dumpinfo/MICROMAKE_3D/MICROMAKE 原图/IMG_20150511_181304.jpg

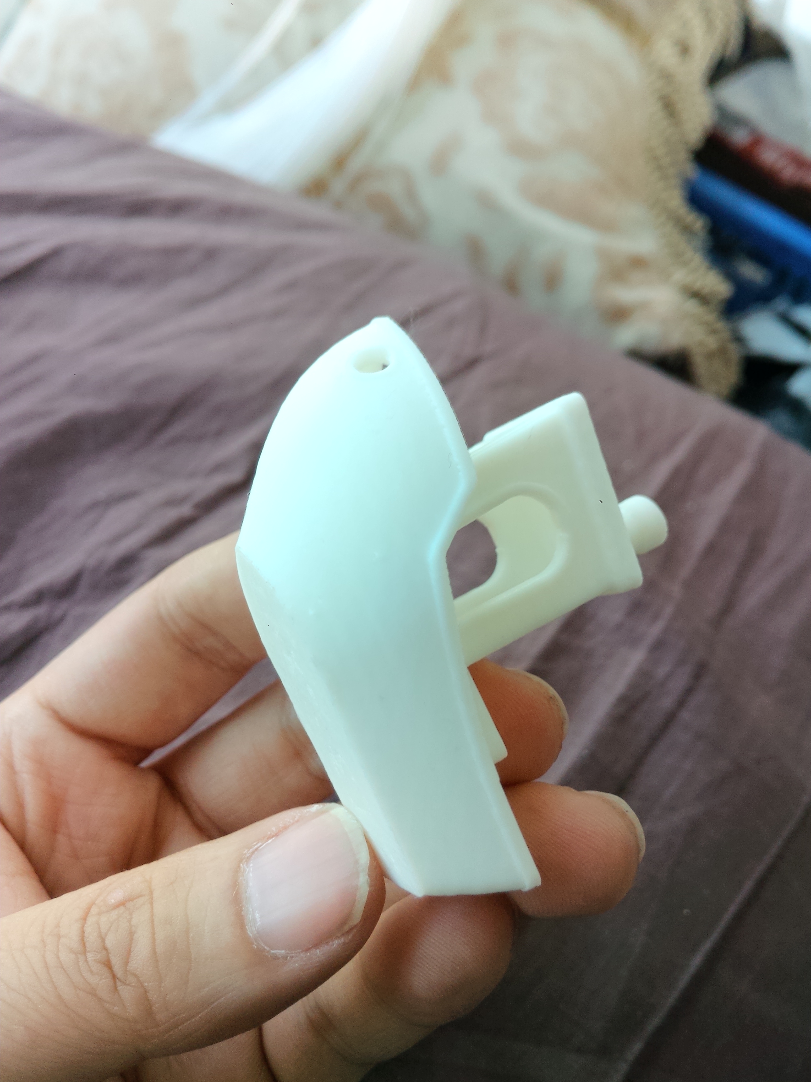
MICROMAKE 原图/IMG_20150511_181304.jpg
