dumpinfo/MICROMAKE_3D/MICROMAKE 原图/IMG_20150913_160210.jpg

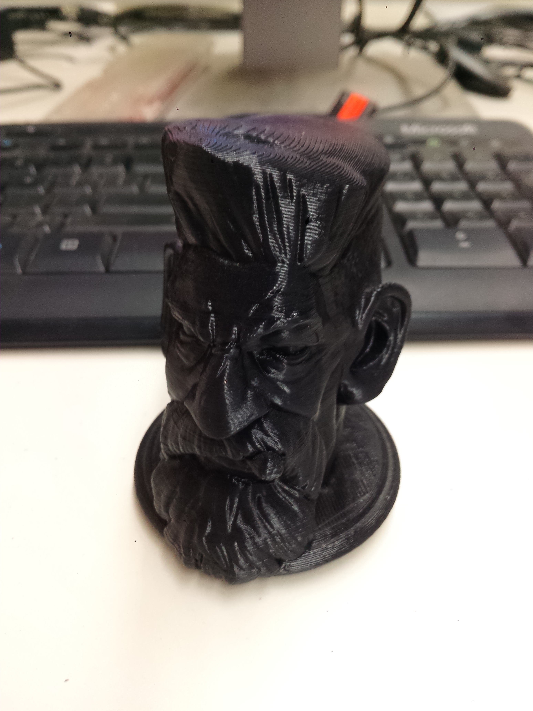
MICROMAKE 原图/IMG_20150913_160210.jpg
