dumpinfo/MICROMAKE_3D/MICROMAKE 文档/Micromake 3D打印机Mac系统软件安装.pdf

1、网盘【MICROMAKE】目录下载，Cura-15.04.0822-MacOS.dmg，双击载入镜像安装。 2、网盘【MICROMAKE 文档】目录下载 CH341SER_MAC.ZIP，解压后运行 CH34x_Install.pkg 安装串口驱动后重启。
3、打开 Cura，选择 Micromake D1 机型后，【机型】菜单，点击【安装默认固件】。（Mac 系 统串口波特率最高 115200，必须重刷固件换成 115200 波特率版本）。 4、如无法连接打印机，请打开 Cura【机型】【机型设置】，确认波特率是设置成 115200 的， 并且点击端口后面的下拉列表，看是否识别出串口，如/dev/cu.wchusbserial1410 类似，如 没有的话，请升级 OS X 10.9 以上版本系统。 5、打印机液晶屏菜单，【Configuration】【General】查看 Baudrate 是否为 115200，如不 是，请进行第 3 步的重刷固件。
