dumpinfo/MICROMAKE_3D/MICROMAKE 文档/金属液晶屏外壳安装教程.pdf

# 金属液晶屏外壳安装教程

## 所需工具：

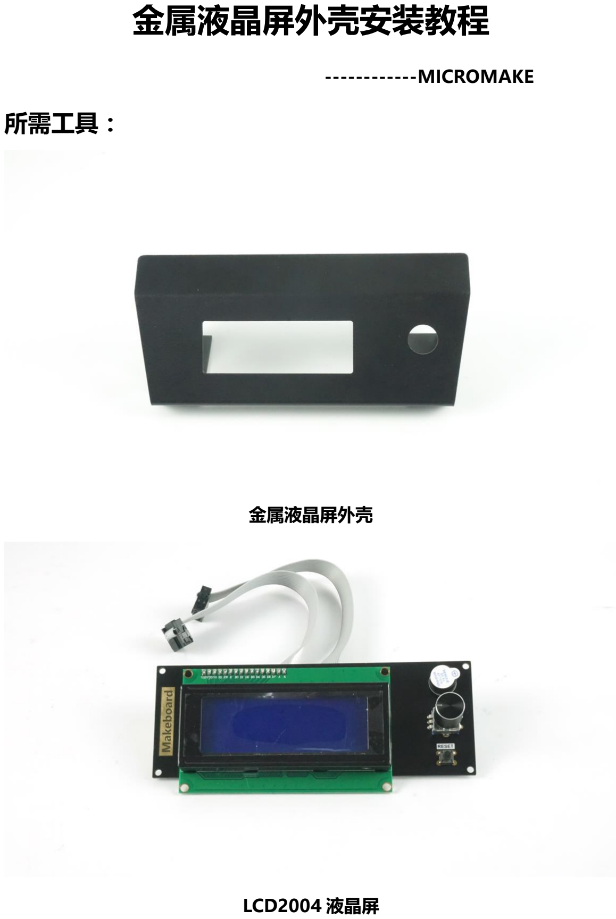
[picture p17: page 1]

------------MICROMAKE

金属液晶屏外壳

LCD2004 液晶屏

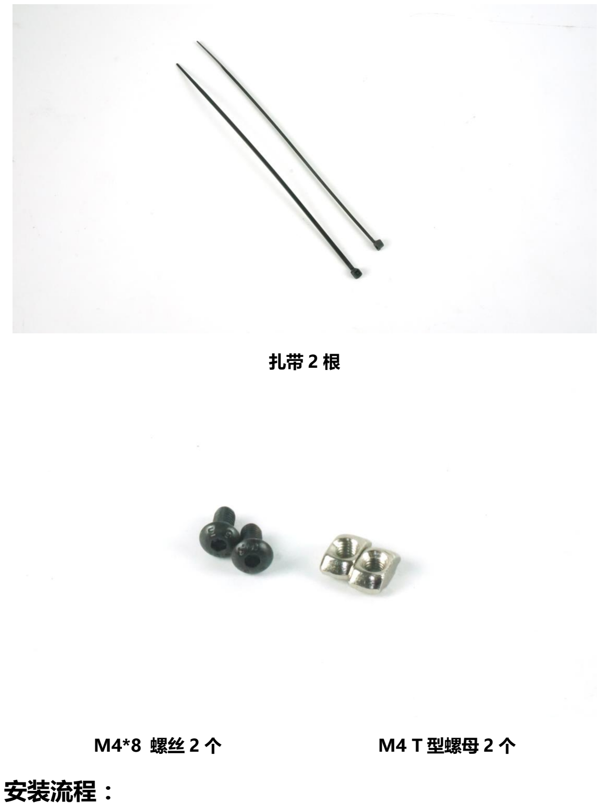
[picture p18: page 2]

扎带 2 根

M4*8 螺丝 2 个 | M4 T 型螺母 2 个

## 安装流程：

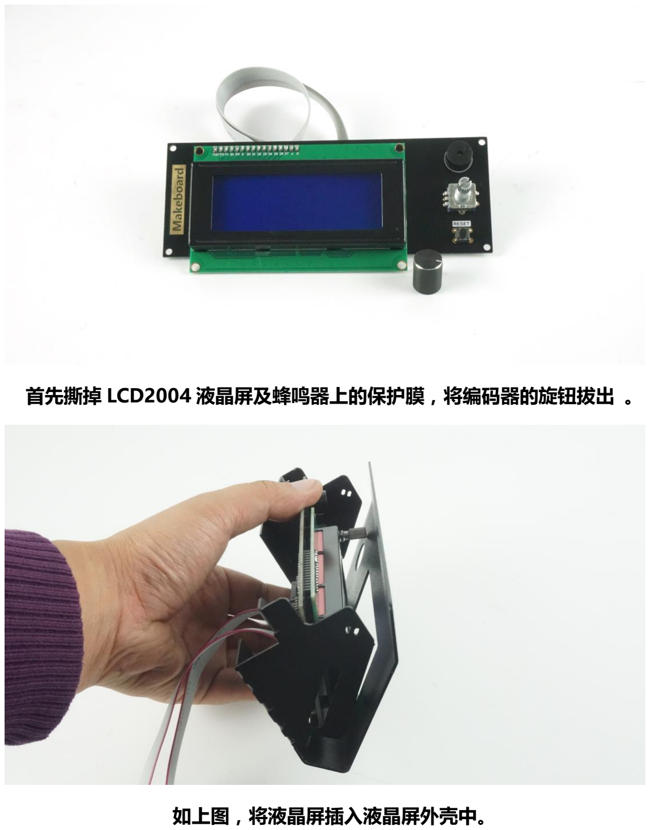
[picture p19: page 3]

首先撕掉 LCD2004 液晶屏及蜂鸣器上的保护膜，将编码器的旋钮拔出 。

如上图，将液晶屏插入液晶屏外壳中。

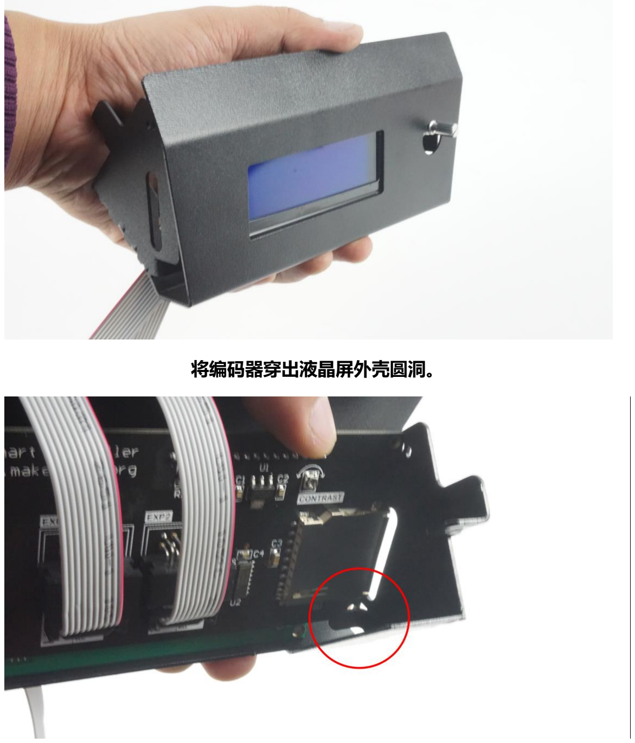
[picture p20: page 4]

将编码器穿出液晶屏外壳圆洞。

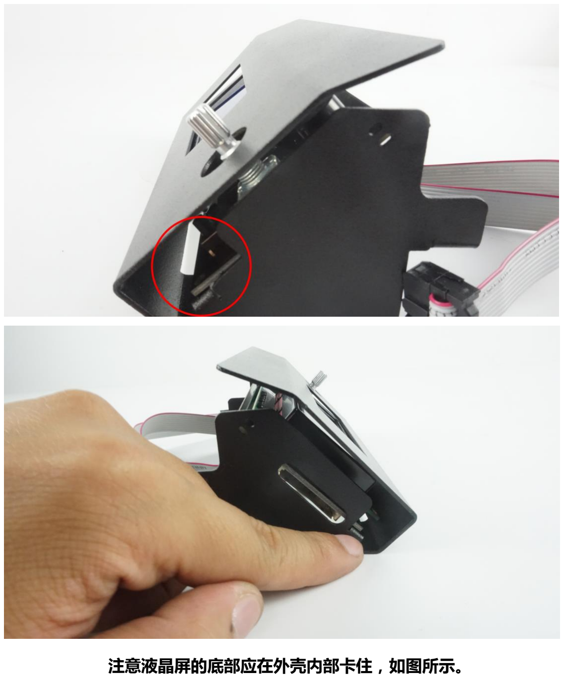
[picture p21: page 5]

注意液晶屏的底部应在外壳内部卡住，如图所示。

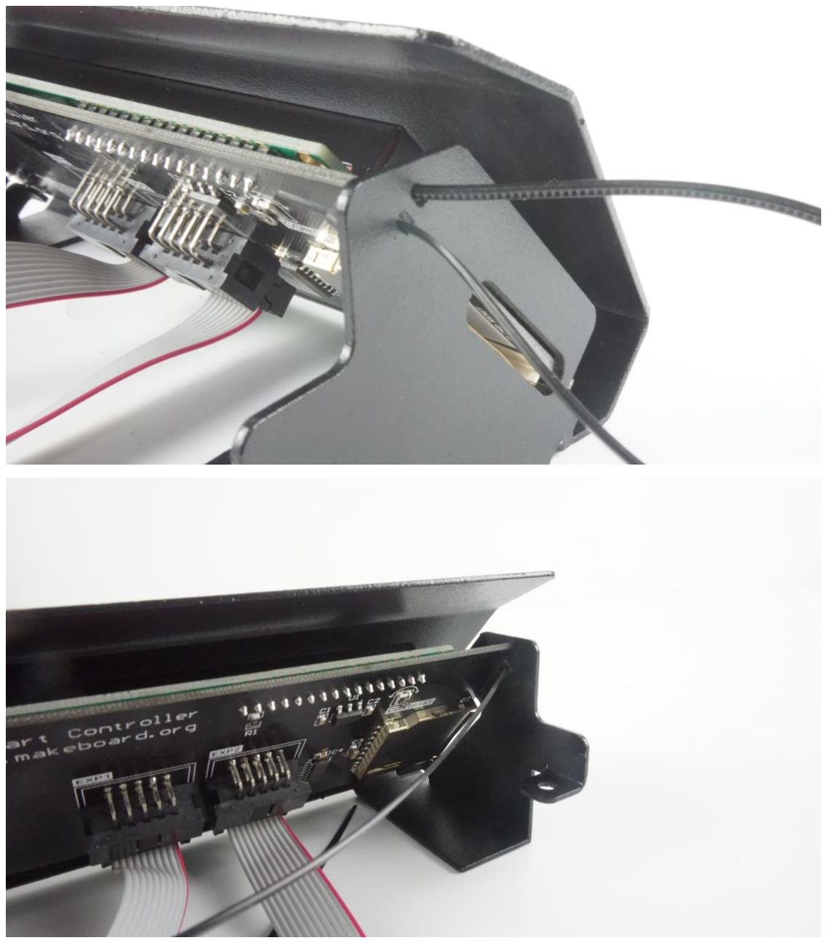
[picture p22: page 6]
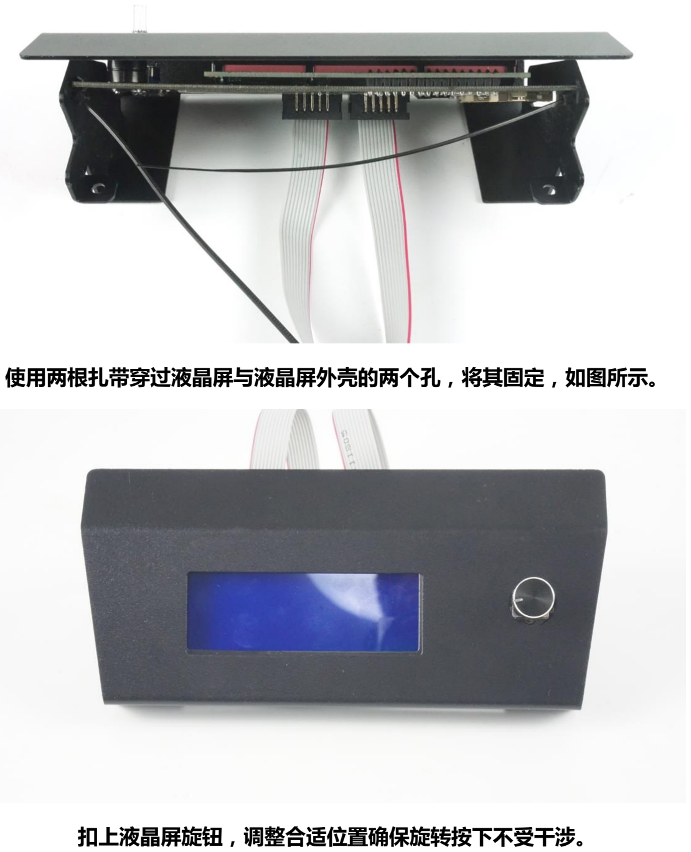
[picture p23: page 7]

使用两根扎带穿过液晶屏与液晶屏外壳的两个孔，将其固定，如图所示。

扣上液晶屏旋钮，调整合适位置确保旋转按下不受干涉。

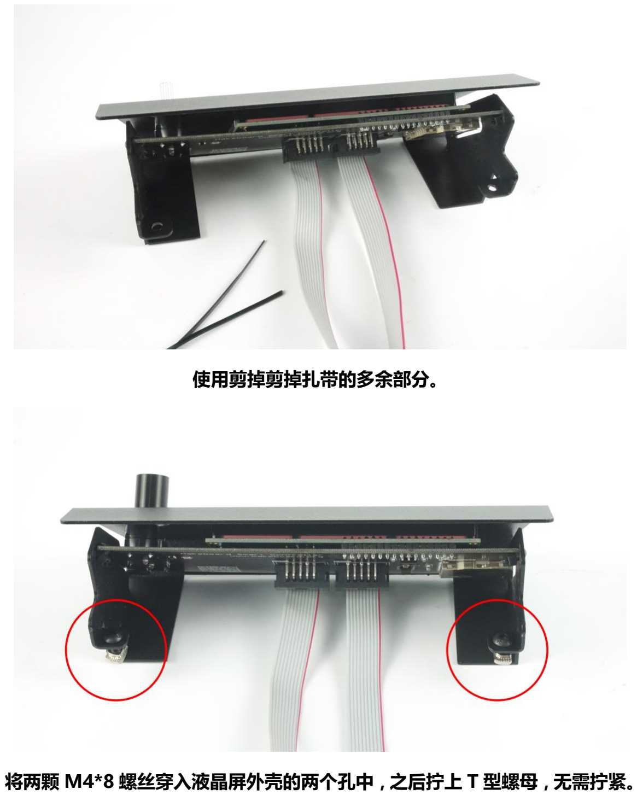
[picture p24: page 8]

使用剪掉剪掉扎带的多余部分。

将两颗 M4*8 螺丝穿入液晶屏外壳的两个孔中，之后拧上 T 型螺母，无需拧紧。

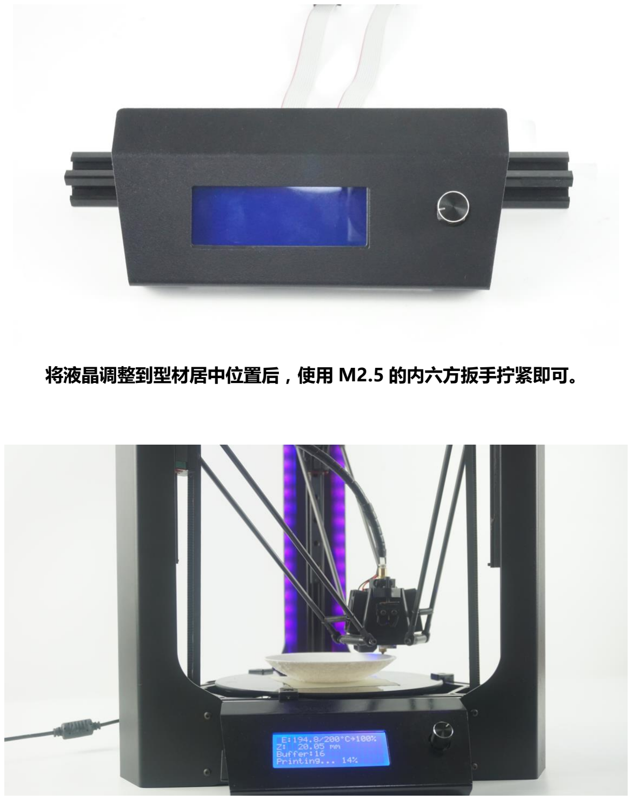
[picture p25: page 9]

将液晶调整到型材居中位置后，使用 M2.5 的内六方扳手拧紧即可。
