dumpinfo/MICROMAKE_3D/MICROMAKE 原图/IMG20151123162052.jpg

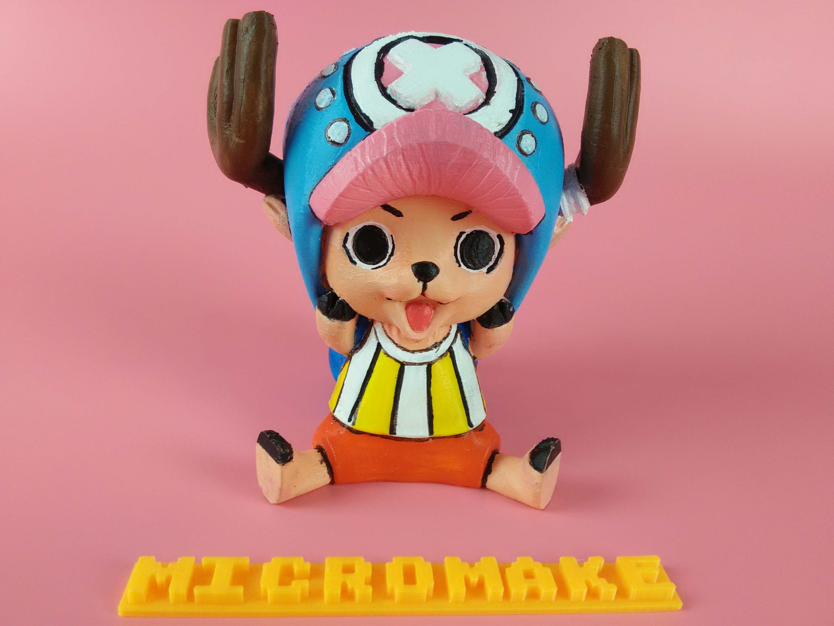
MICROMAKE 原图/IMG20151123162052.jpg
