dumpinfo/MICROMAKE_3D/MICROMAKE 原图/IMG_20150512_173231.jpg

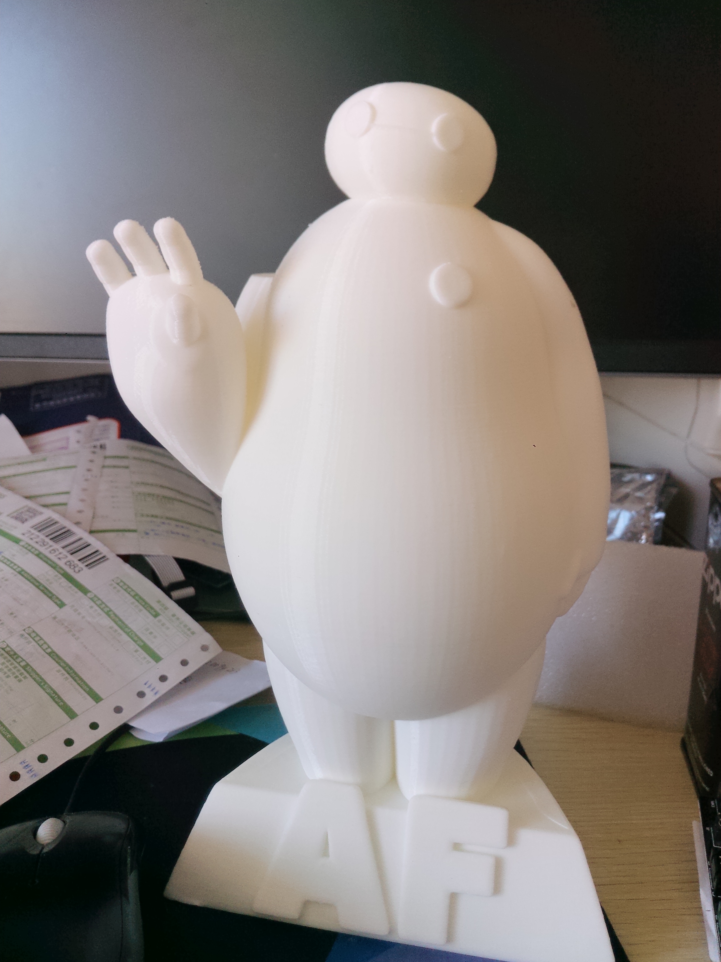
MICROMAKE 原图/IMG_20150512_173231.jpg
