dumpinfo/MICROMAKE_3D/MICROMAKE 原图/IMG_20150521_191225.jpg

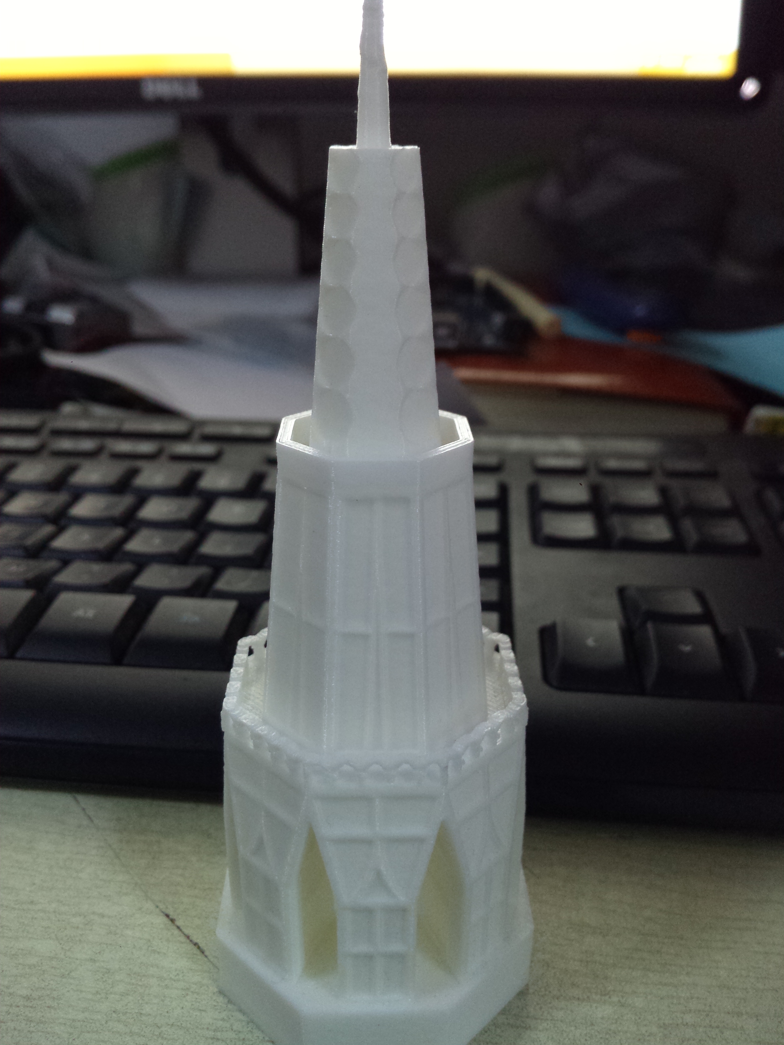
MICROMAKE 原图/IMG_20150521_191225.jpg
