dumpinfo/MICROMAKE_3D/MICROMAKE 原图/IMG_20150529_174008.jpg

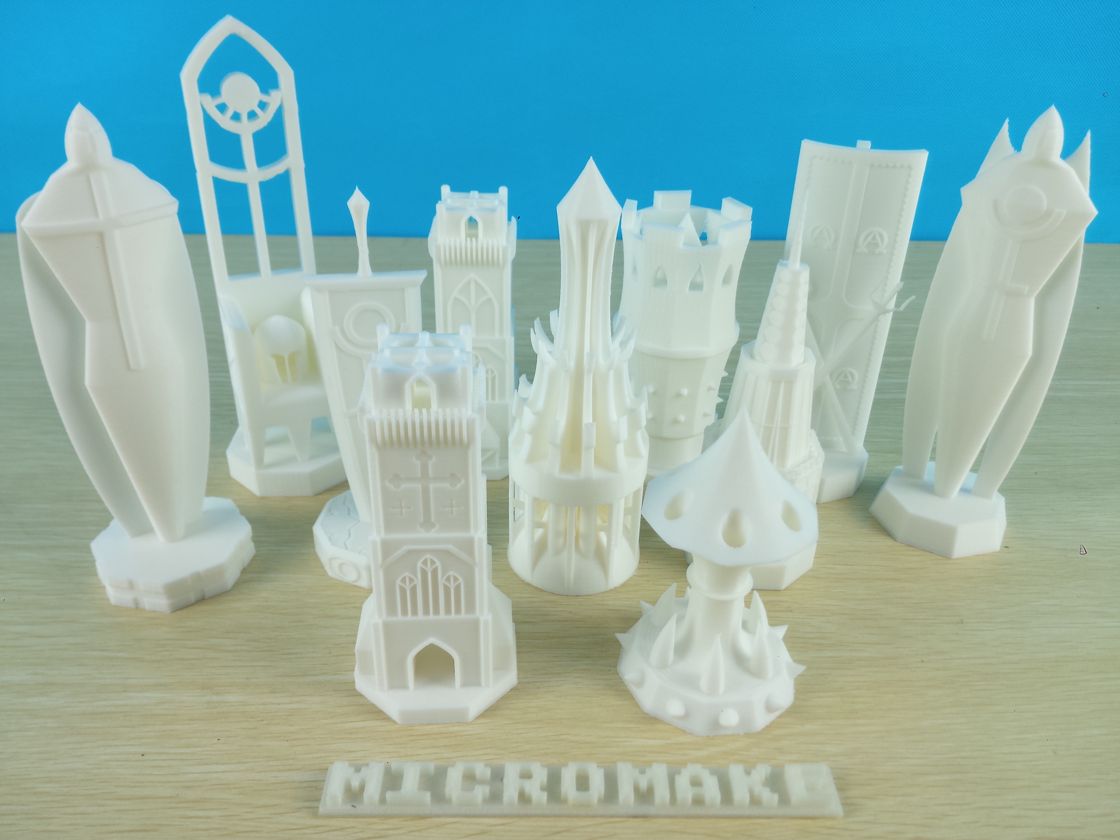
MICROMAKE 原图/IMG_20150529_174008.jpg
