dumpinfo/MICROMAKE_3D/MICROMAKE 原图/IMG_20150719_093453.jpg

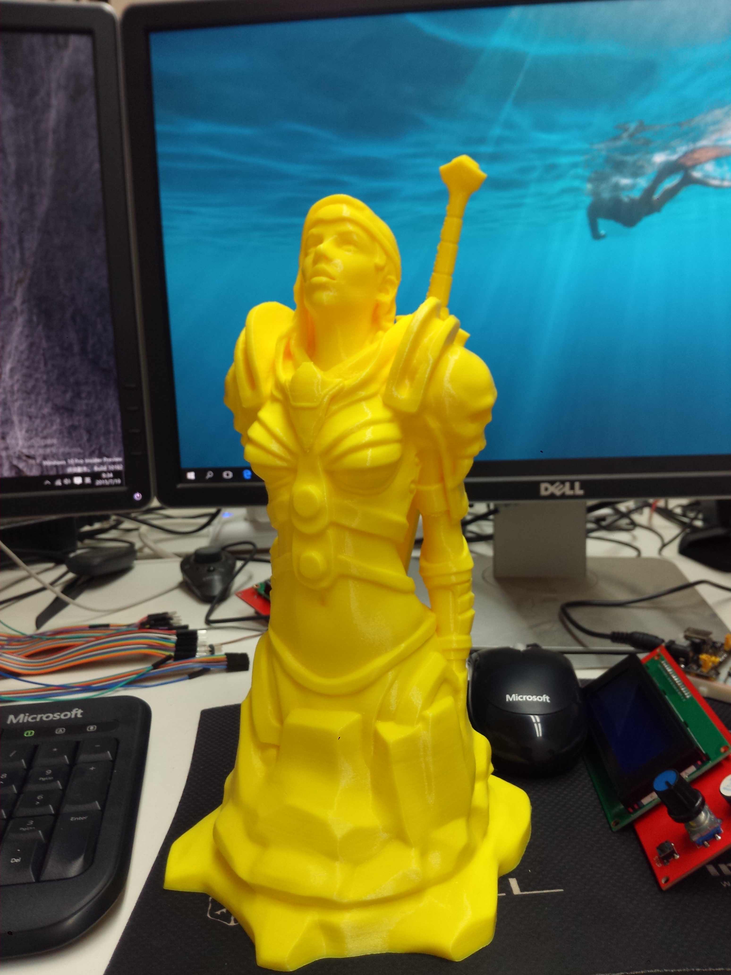
MICROMAKE 原图/IMG_20150719_093453.jpg
