dumpinfo/MICROMAKE_3D/MICROMAKE 原图/IMG_20151117_130504.jpg

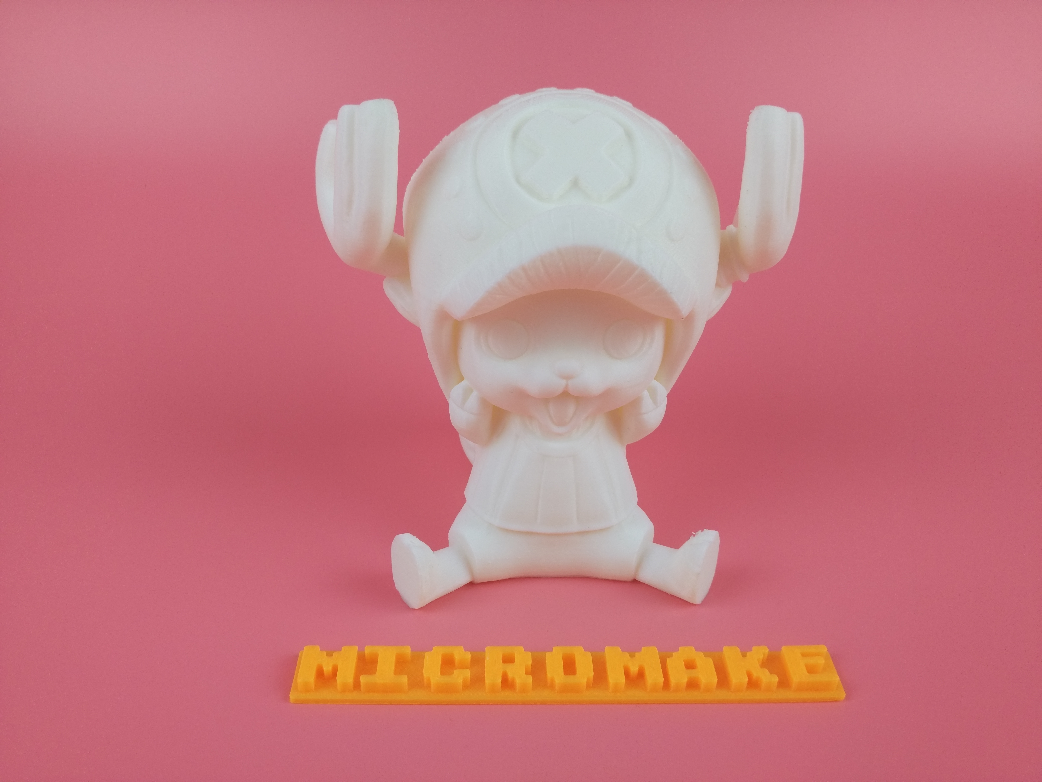
MICROMAKE 原图/IMG_20151117_130504.jpg
