dumpinfo/MICROMAKE_3D/MICROMAKE 原图/IMG_20151117_131758.jpg

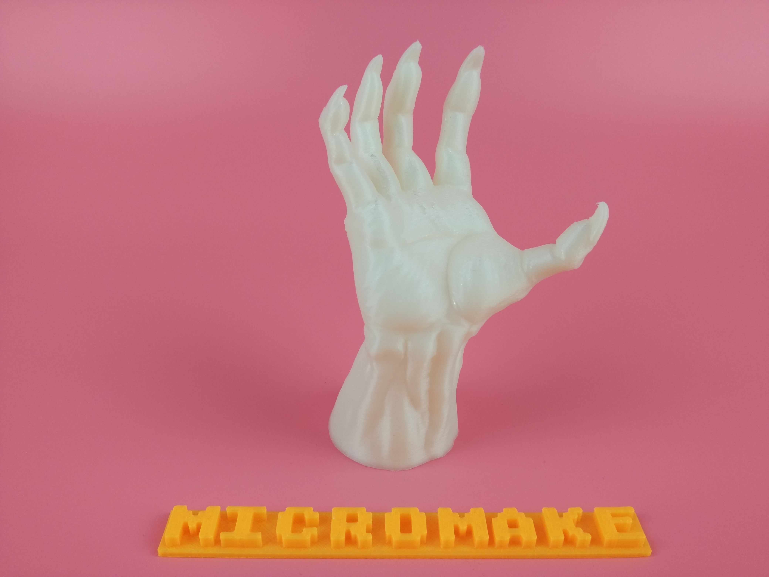
MICROMAKE 原图/IMG_20151117_131758.jpg
