dumpinfo/MICROMAKE_3D/MICROMAKE L1 光固化资料/测试模型/僵尸猎人头.stl

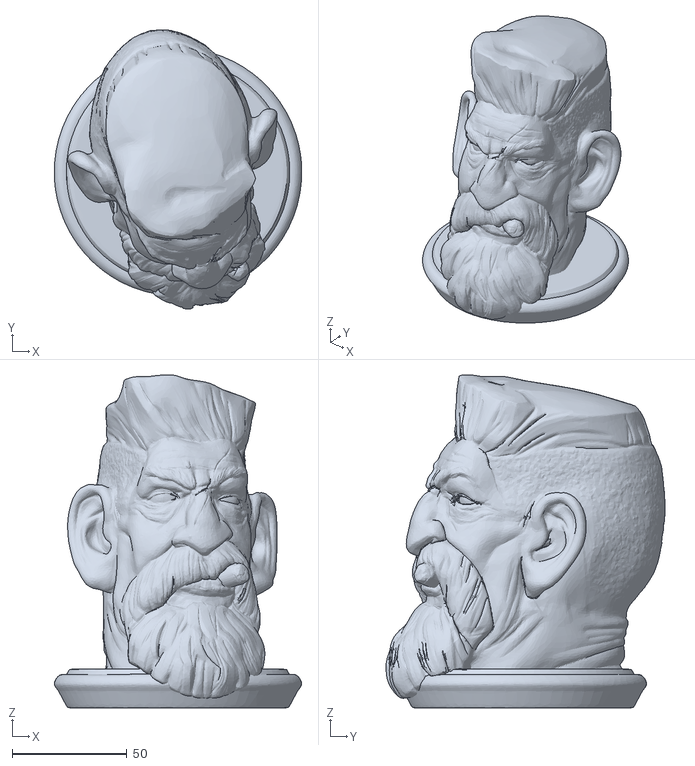
[picture p35: CAD file, 2019-02-17]
MICROMAKE L1 光固化资料/测试模型/僵尸猎人头.stl
107.7 x 121.6 x 145.0
