dumpinfo/MICROMAKE_3D/MICROMAKE 模型/全套非标件模型/螺丝.STL

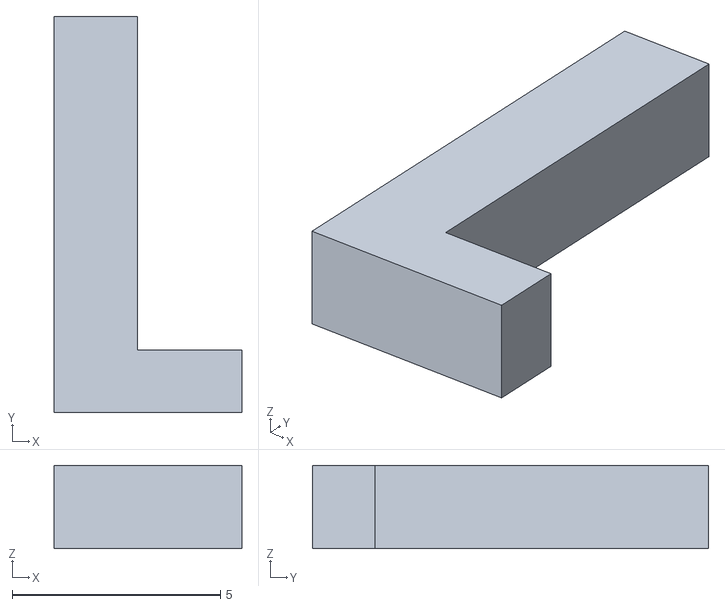
[picture p36: CAD file, 2019-02-17]
MICROMAKE 模型/全套非标件模型/螺丝.STL
4.50 x 9.50 x 2.00
