dumpinfo/MICROMAKE_3D/MICROMAKE 模型/手动调平用模型/手动测试.amf

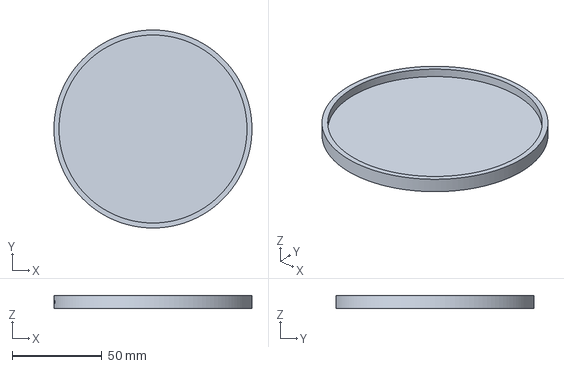
[picture p37: CAD file, 2019-02-17]
MICROMAKE 模型/手动调平用模型/手动测试.amf
110.0 x 110.0 x 6.96 mm
