dumpinfo/MICROMAKE_3D/MICROMAKE 模型/料架.STL

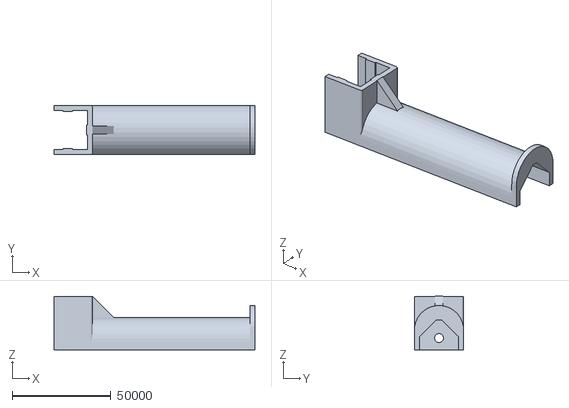
[picture p38: CAD file, 2019-02-17]
MICROMAKE 模型/料架.STL
102000.0 x 25000.0 x 27250.0
