dumpinfo/MICROMAKE_3D/MICROMAKE L1 光固化资料/测试模型/标准模型.stl

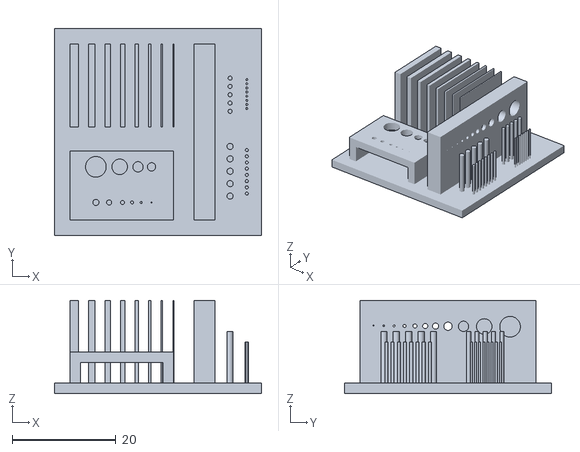
[picture p39: CAD file, 2019-02-17]
MICROMAKE L1 光固化资料/测试模型/标准模型.stl
40.0 x 40.0 x 18.0
