dumpinfo/MICROMAKE_3D/MICROMAKE 模型/全套非标件模型/T型螺母.STL

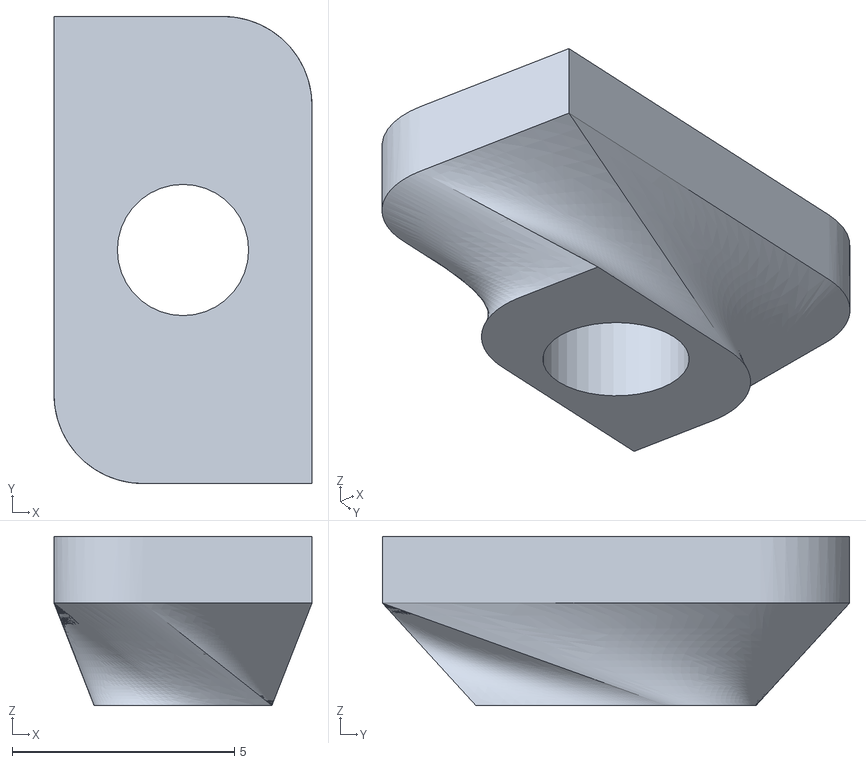
[picture p40: CAD file, 2019-02-17]
MICROMAKE 模型/全套非标件模型/T型螺母.STL
5.80 x 10.5 x 3.80
