dumpinfo/MICROMAKE_3D/MICROMAKE L1 光固化资料/测试模型/test.stl

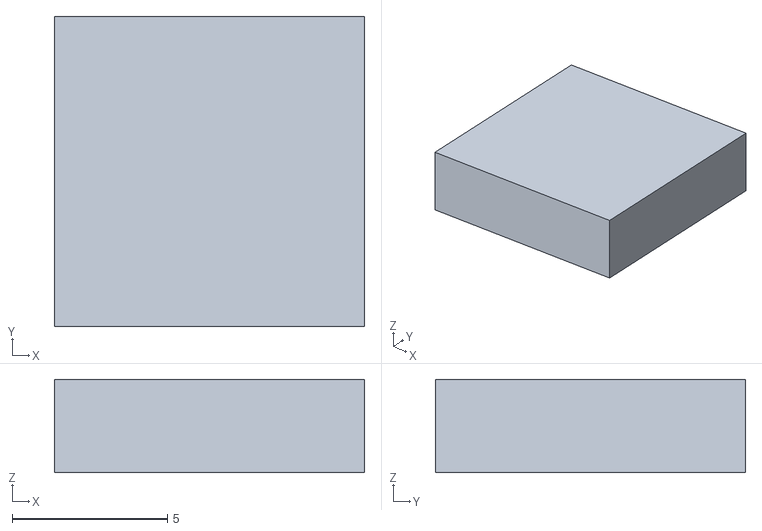
[picture p41: CAD file, 2019-02-17]
MICROMAKE L1 光固化资料/测试模型/test.stl
10.0 x 10.0 x 3.00
