dumpinfo/MICROMAKE_3D/MICROMAKE 模型/全套非标件模型/效应器.STL

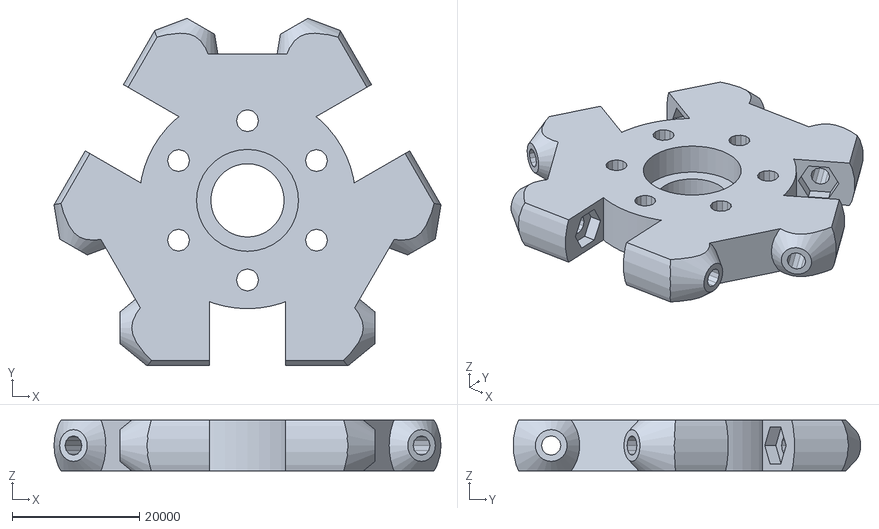
[picture p42: CAD file, 2019-02-17]
MICROMAKE 模型/全套非标件模型/效应器.STL
60744.2 x 54515.7 x 8000.0
