dumpinfo/MICROMAKE_3D/MICROMAKE L1 光固化资料/测试模型/插扣单支撑.stl

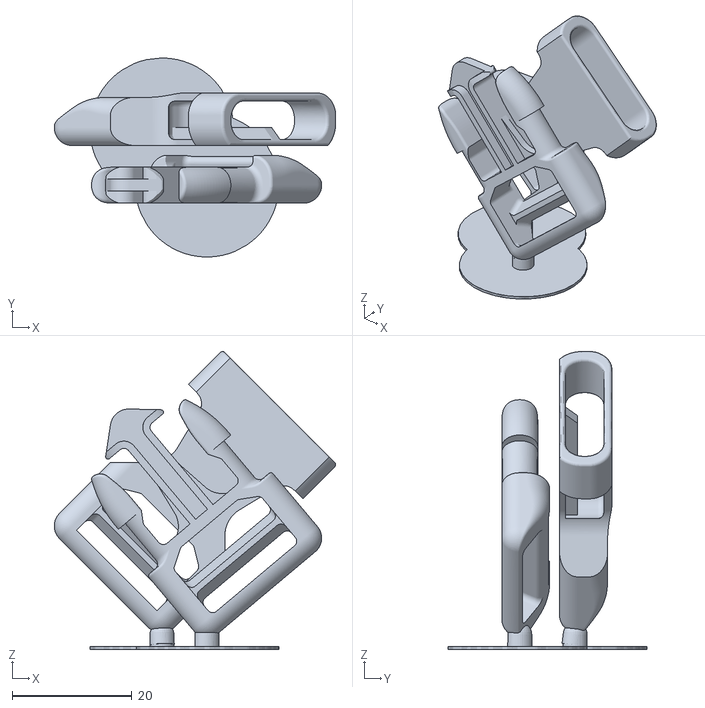
[picture p43: CAD file, 2019-02-17]
MICROMAKE L1 光固化资料/测试模型/插扣单支撑.stl
47.0 x 33.2 x 49.7
