dumpinfo/MICROMAKE_3D/MICROMAKE 模型/全套非标件模型/线轨皮带连接件.STL

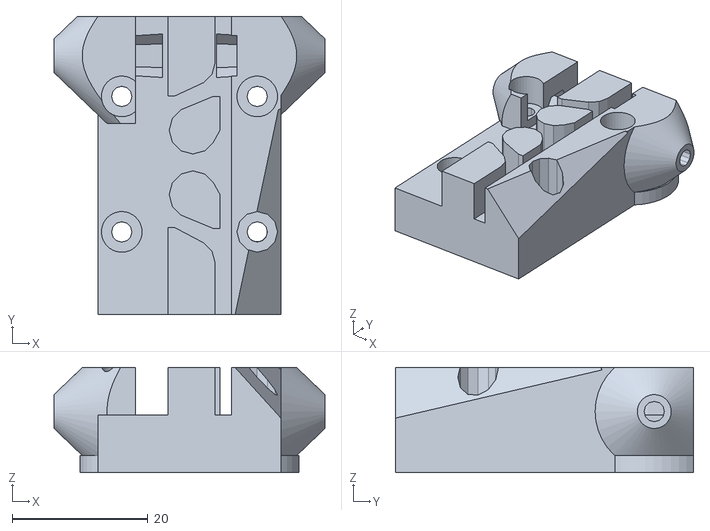
[picture p44: CAD file, 2019-02-17]
MICROMAKE 模型/全套非标件模型/线轨皮带连接件.STL
40.0 x 44.0 x 15.5
