dumpinfo/MICROMAKE_3D/MICROMAKE L1 光固化资料/测试模型/球 需加支撑.stl

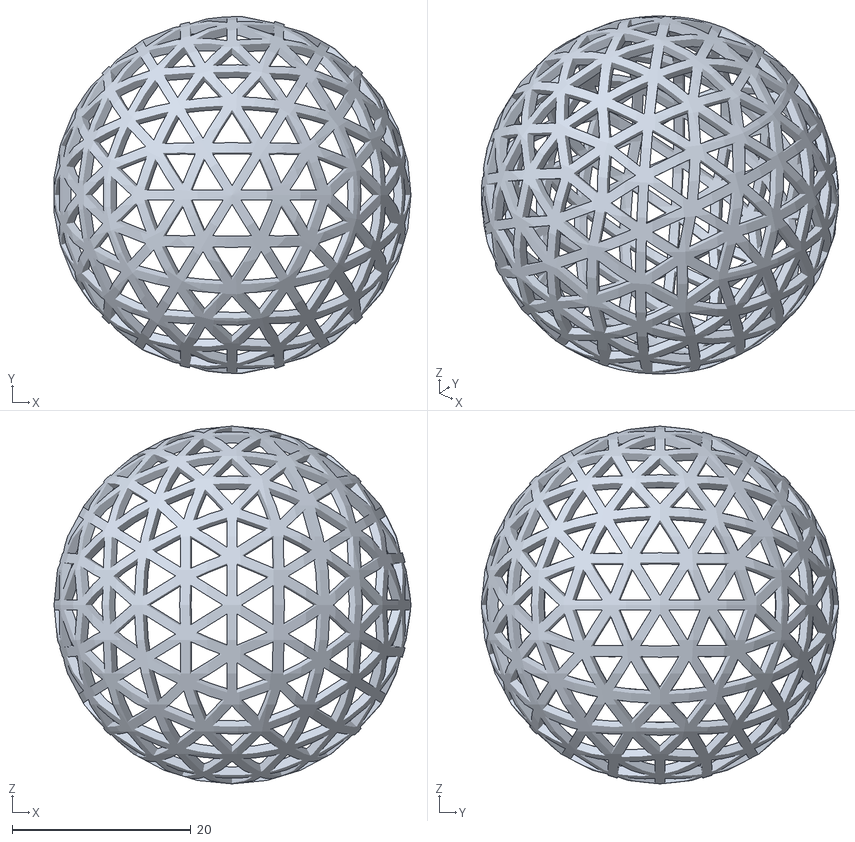
[picture p45: CAD file, 2019-02-17]
MICROMAKE L1 光固化资料/测试模型/球 需加支撑.stl
39.9 x 40.0 x 40.0
