dumpinfo/MICROMAKE_3D/MICROMAKE 模型/全套非标件模型/自调平效应器 夹具.STL

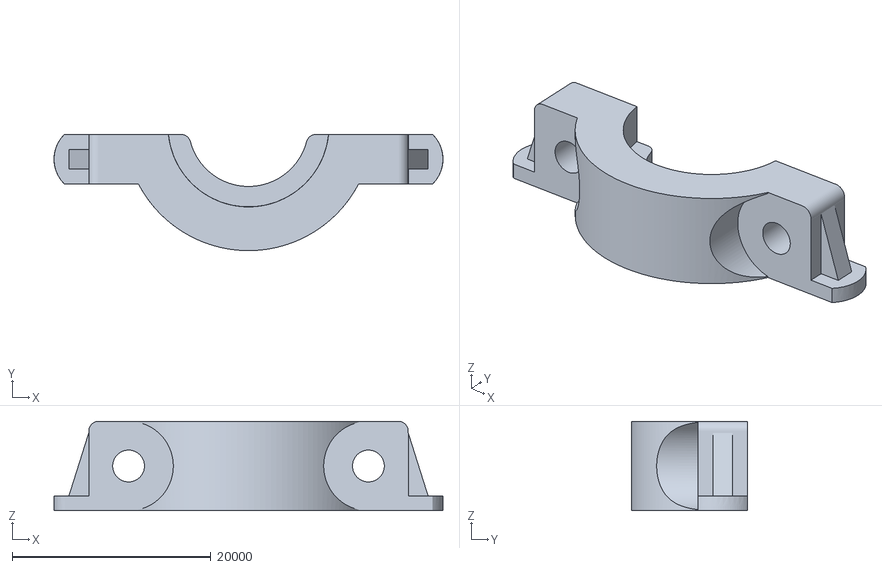
[picture p46: CAD file, 2019-02-17]
MICROMAKE 模型/全套非标件模型/自调平效应器 夹具.STL
39140.0 x 11700.0 x 9000.0
