dumpinfo/MICROMAKE_3D/MICROMAKE 模型/全套非标件模型/控制板支架.STL

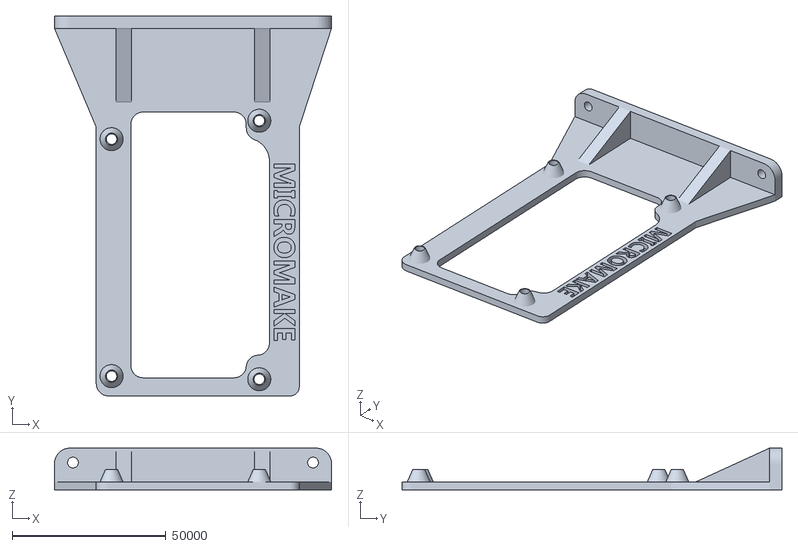
[picture p47: CAD file, 2019-02-17]
MICROMAKE 模型/全套非标件模型/控制板支架.STL
90000.0 x 123421.6 x 13600.0
