dumpinfo/MICROMAKE_3D/MICROMAKE 模型/全套非标件模型/自调平效应器 外围.STL

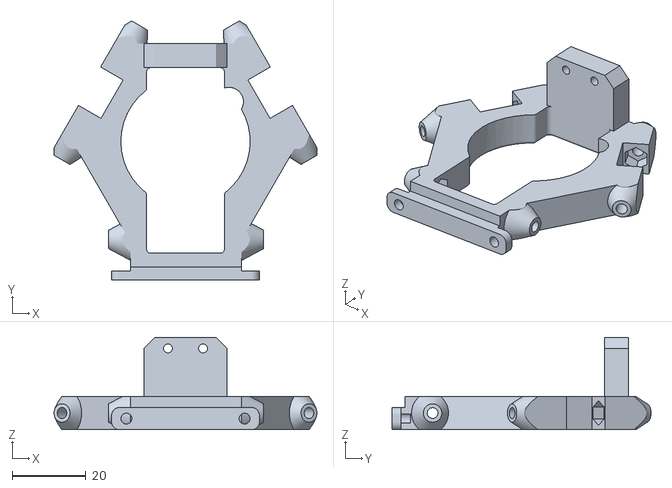
[picture p48: CAD file, 2019-02-17]
MICROMAKE 模型/全套非标件模型/自调平效应器 外围.STL
71.2 x 70.2 x 25.0
