dumpinfo/MICROMAKE_3D/MICROMAKE 模型/全套非标件模型/自调平效应器 中间件.STL

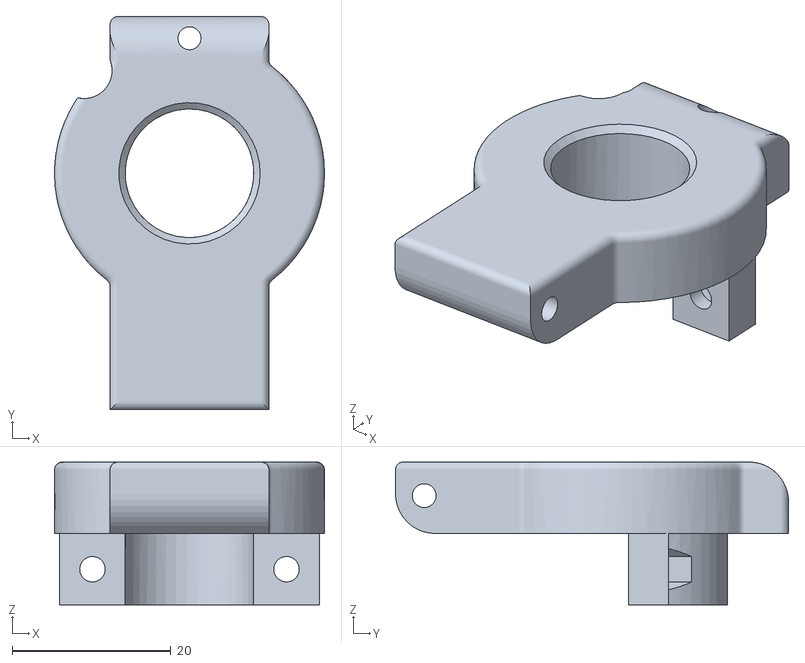
[picture p49: CAD file, 2019-02-17]
MICROMAKE 模型/全套非标件模型/自调平效应器 中间件.STL
34.0 x 49.5 x 18.0
