dumpinfo/MICROMAKE_3D/MICROMAKE 模型/全套非标件模型/滑车.STL

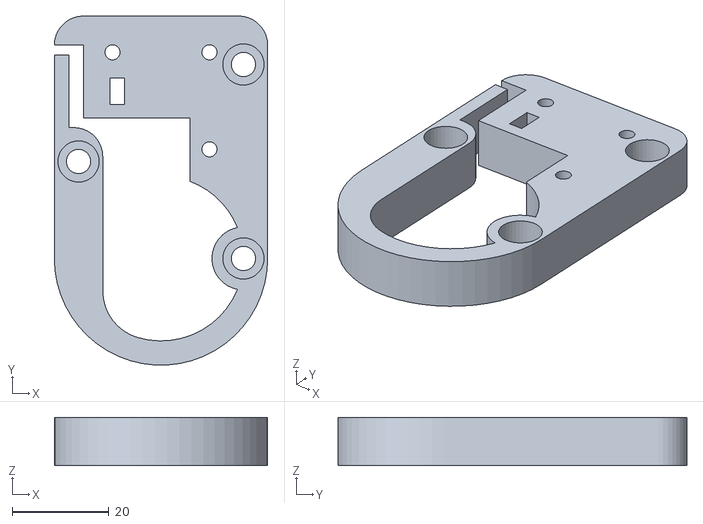
[picture p50: CAD file, 2019-02-17]
MICROMAKE 模型/全套非标件模型/滑车.STL
44.0 x 72.0 x 10.0
