dumpinfo/MICROMAKE_3D/MICROMAKE 模型/全套非标件模型/风扇支架 .STL

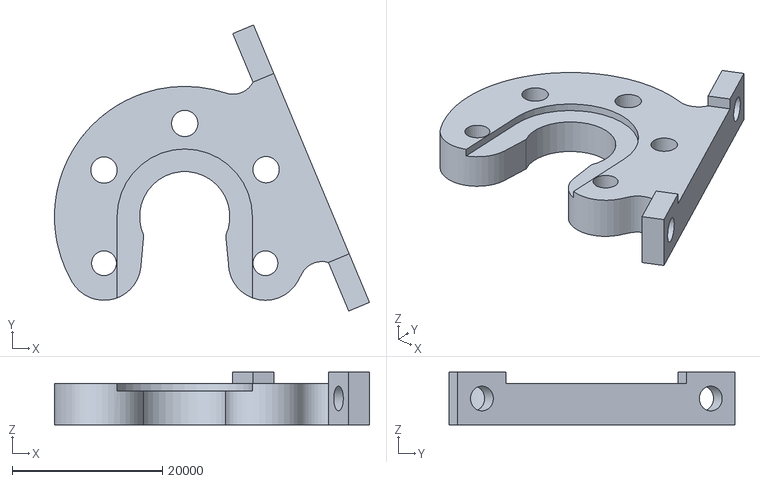
[picture p51: CAD file, 2019-02-17]
MICROMAKE 模型/全套非标件模型/风扇支架 .STL
41903.6 x 38061.6 x 7000.0
