dumpinfo/MICROMAKE_3D/MICROMAKE 模型/全套非标件模型/液晶屏支架.STL

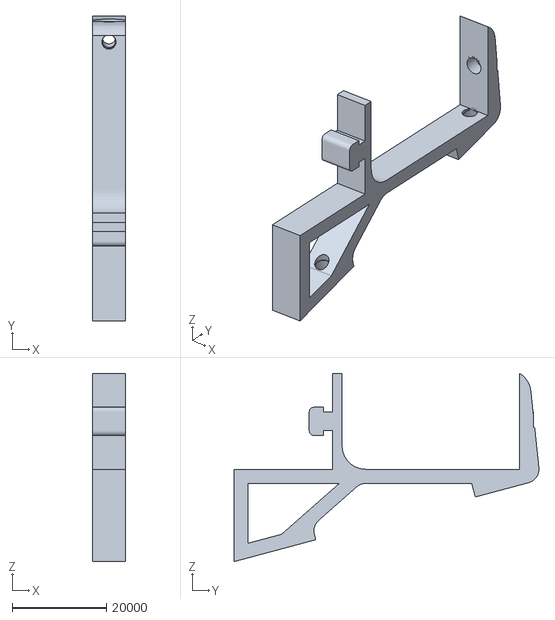
[picture p52: CAD file, 2019-02-17]
MICROMAKE 模型/全套非标件模型/液晶屏支架.STL
7000.0 x 64877.5 x 40049.7
