dumpinfo/MICROMAKE_3D/MICROMAKE 模型/全套非标件模型/送丝机夹具.STL

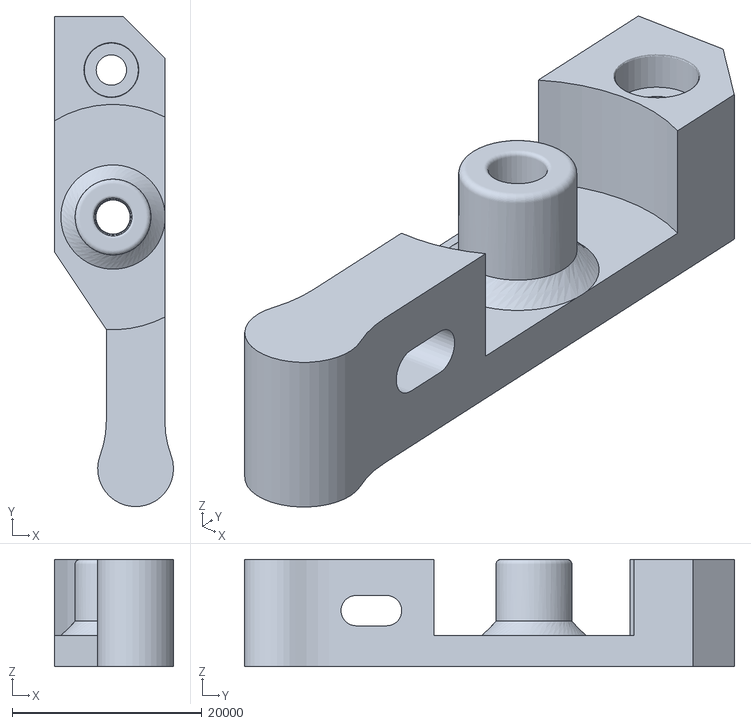
[picture p53: CAD file, 2019-02-17]
MICROMAKE 模型/全套非标件模型/送丝机夹具.STL
12553.6 x 51681.4 x 11300.0
