dumpinfo/MICROMAKE_3D/MICROMAKE 模型/全套非标件模型/一体滑车.STL

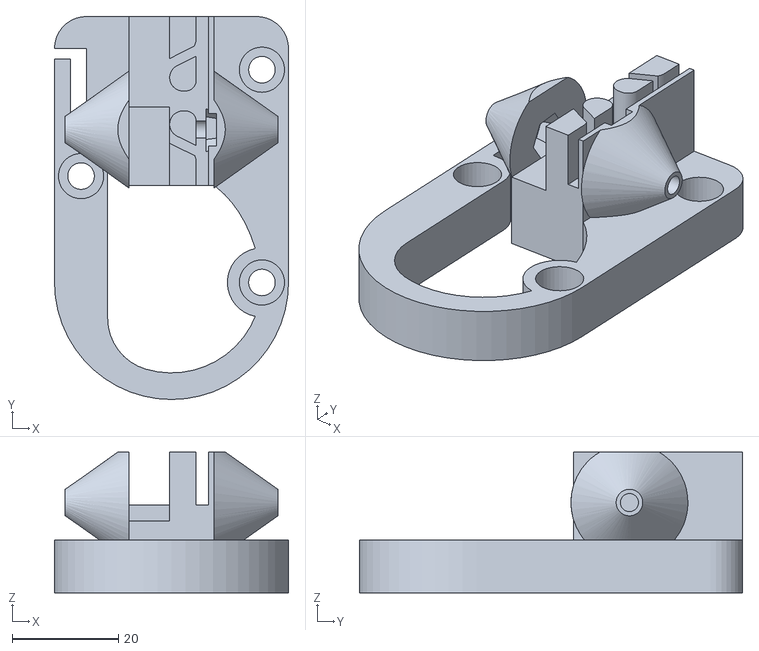
[picture p54: CAD file, 2019-02-17]
MICROMAKE 模型/全套非标件模型/一体滑车.STL
44.0 x 72.0 x 26.5
