dumpinfo/MICROMAKE_3D/MICROMAKE 模型/全套非标件模型/MICROMAKE.STL

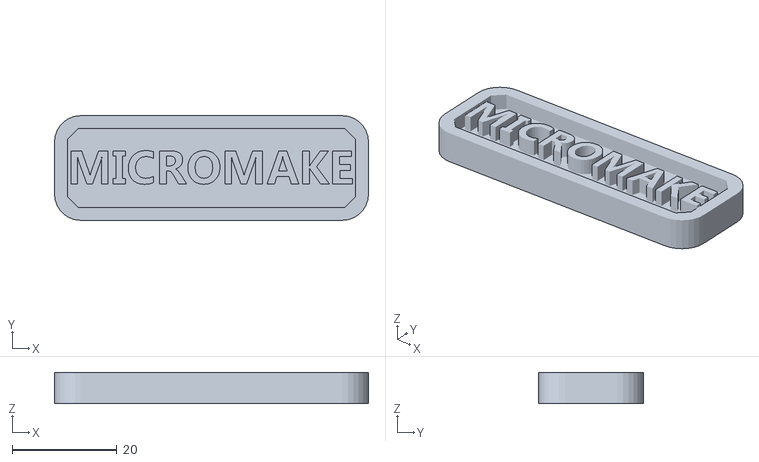
[picture p55: CAD file, 2019-02-17]
MICROMAKE 模型/全套非标件模型/MICROMAKE.STL
60.0 x 20.0 x 6.00
