dumpinfo/MICROMAKE_3D/MICROMAKE 模型/全套非标件模型/上角件.STL

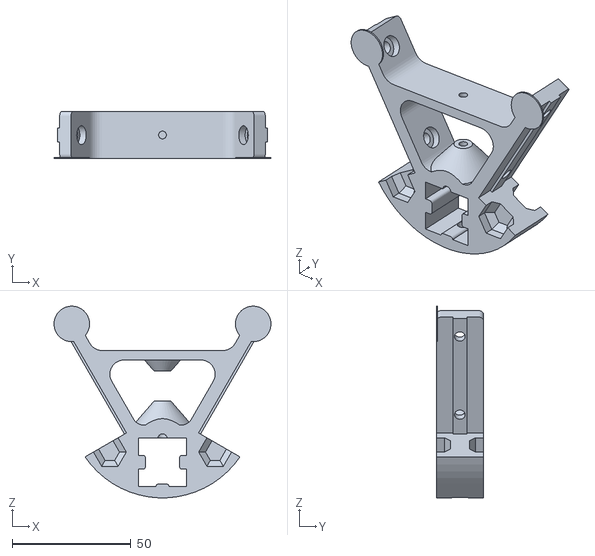
[picture p56: CAD file, 2019-02-17]
MICROMAKE 模型/全套非标件模型/上角件.STL
91.4 x 20.0 x 80.8
