dumpinfo/MICROMAKE_3D/MICROMAKE 模型/全套非标件模型/LOGO.STL

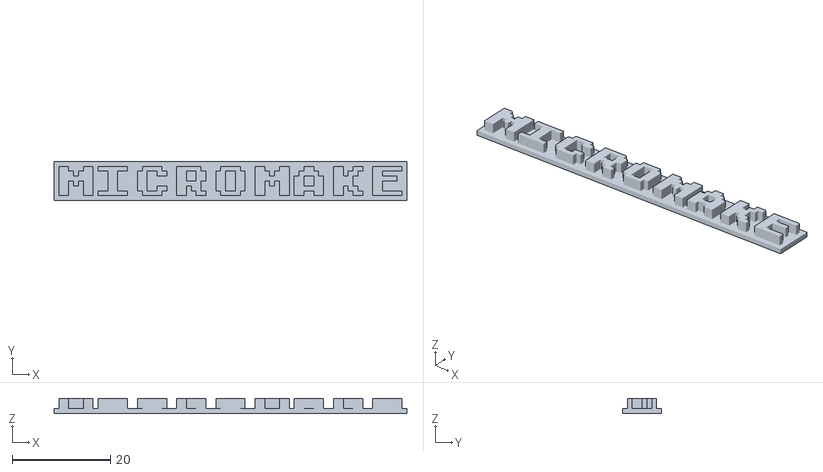
[picture p57: CAD file, 2019-02-17]
MICROMAKE 模型/全套非标件模型/LOGO.STL
72.0 x 8.00 x 3.00
