dumpinfo/MICROMAKE_3D/MICROMAKE 模型/全套非标件模型/皮带滑块.STL

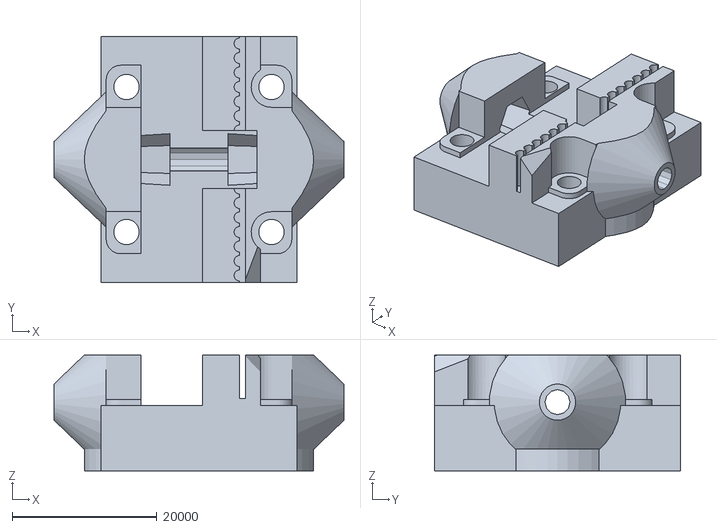
[picture p58: CAD file, 2019-02-17]
MICROMAKE 模型/全套非标件模型/皮带滑块.STL
40000.0 x 34000.0 x 16000.0
