dumpinfo/MICROMAKE_3D/MICROMAKE 模型/全套非标件模型/Leveling.STL

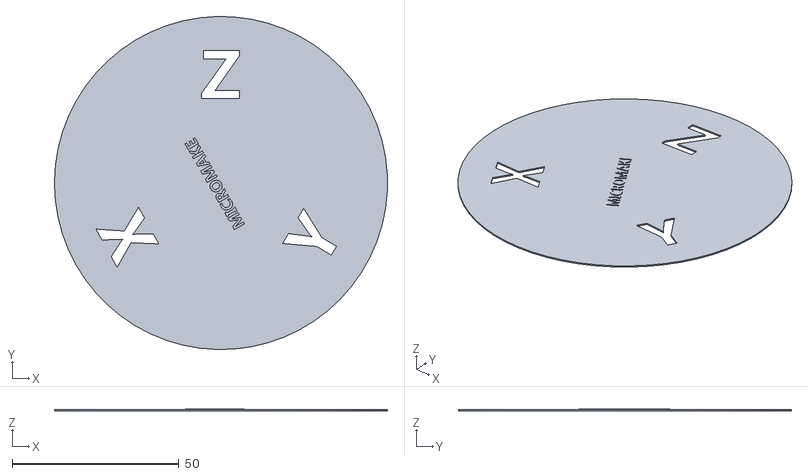
[picture p59: CAD file, 2019-02-17]
MICROMAKE 模型/全套非标件模型/Leveling.STL
100.0 x 100.0 x 0.6
