dumpinfo/MICROMAKE_3D/MICROMAKE 模型/全套非标件模型/测试方块.STL

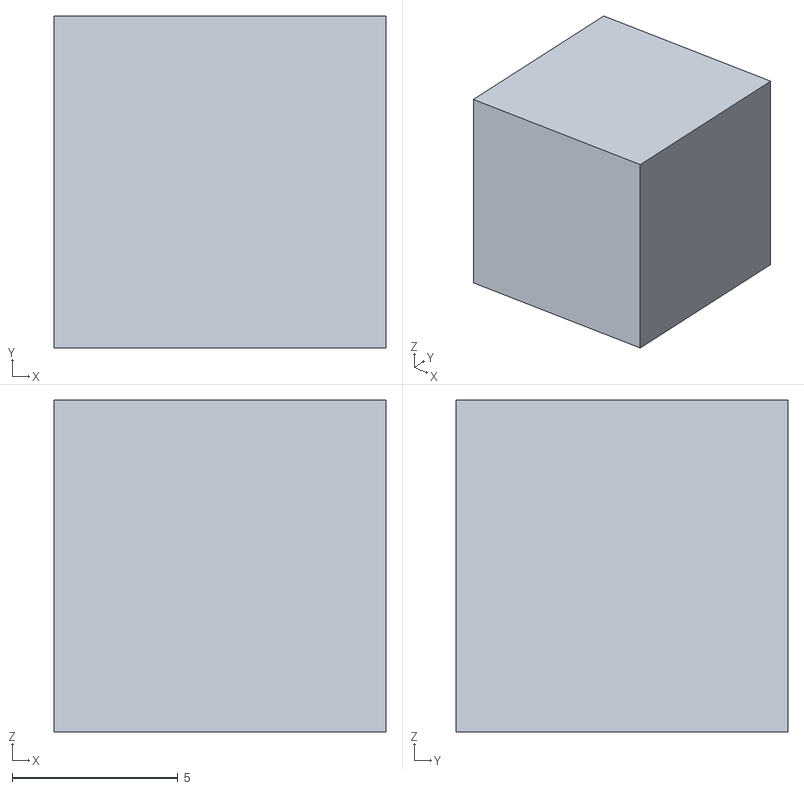
[picture p60: CAD file, 2019-02-17]
MICROMAKE 模型/全套非标件模型/测试方块.STL
10.0 x 10.0 x 10.0
