dumpinfo/MICROMAKE_3D/MICROMAKE 模型/全套非标件模型/限位块.STL

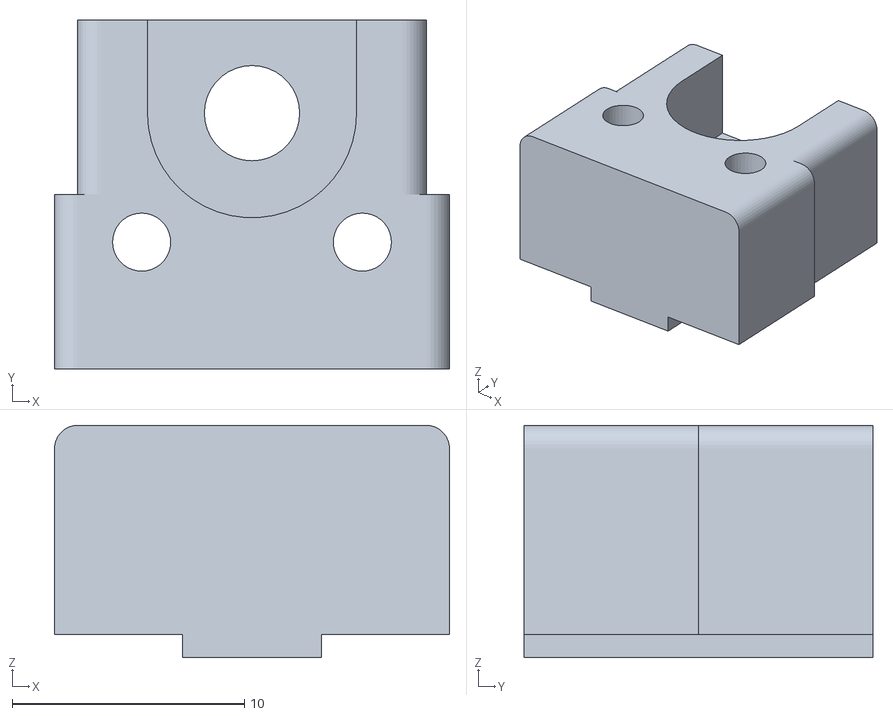
[picture p61: CAD file, 2019-02-17]
MICROMAKE 模型/全套非标件模型/限位块.STL
17.0 x 15.0 x 10.0
