dumpinfo/MICROMAKE_3D/MICROMAKE 模型/全套非标件模型/下角件.STL

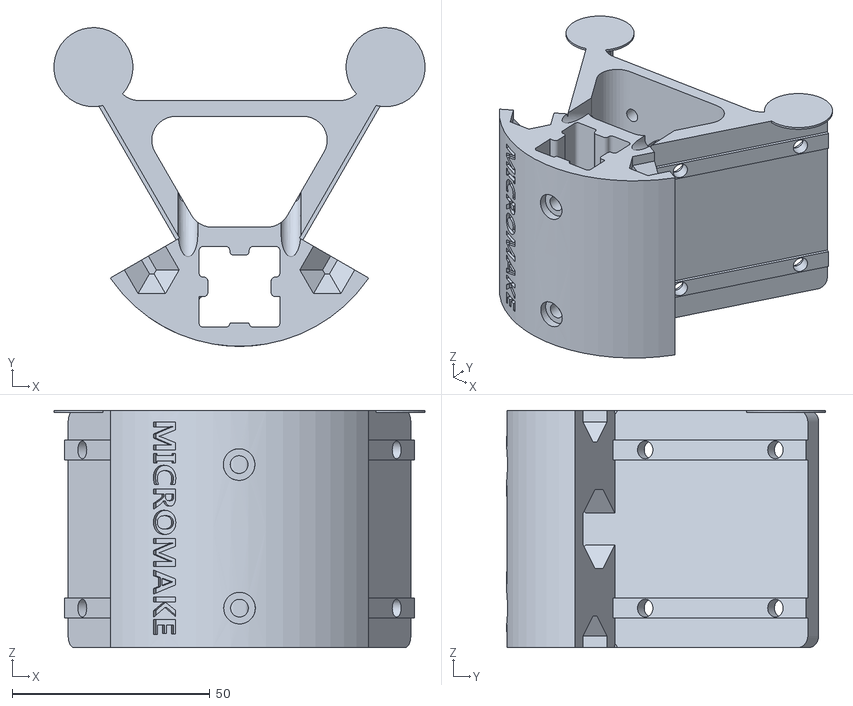
[picture p62: CAD file, 2019-02-17]
MICROMAKE 模型/全套非标件模型/下角件.STL
93.8 x 80.5 x 60.0
