dumpinfo/MICROMAKE_3D/MICROMAKE 模型/全套非标件模型/液晶屏外壳.STL

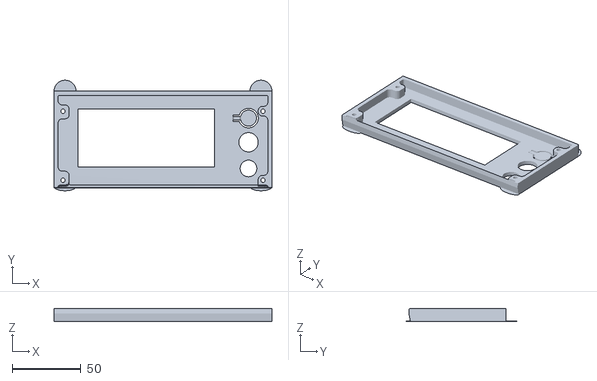
[picture p63: CAD file, 2019-02-17]
MICROMAKE 模型/全套非标件模型/液晶屏外壳.STL
158.0 x 80.2 x 9.50
