dumpinfo/MICROMAKE_3D/MICROMAKE 模型/全套非标件模型/玻璃夹具.STL

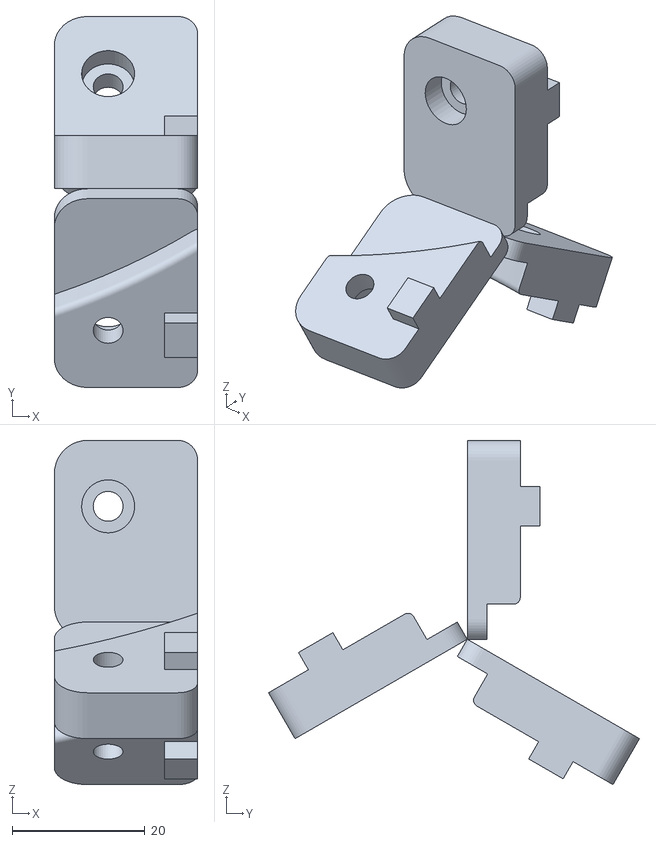
[picture p64: CAD file, 2019-02-17]
MICROMAKE 模型/全套非标件模型/玻璃夹具.STL
21.6 x 56.0 x 51.9
