dumpinfo/MICROMAKE_3D/MICROMAKE 模型/全套非标件模型/送丝机.STL

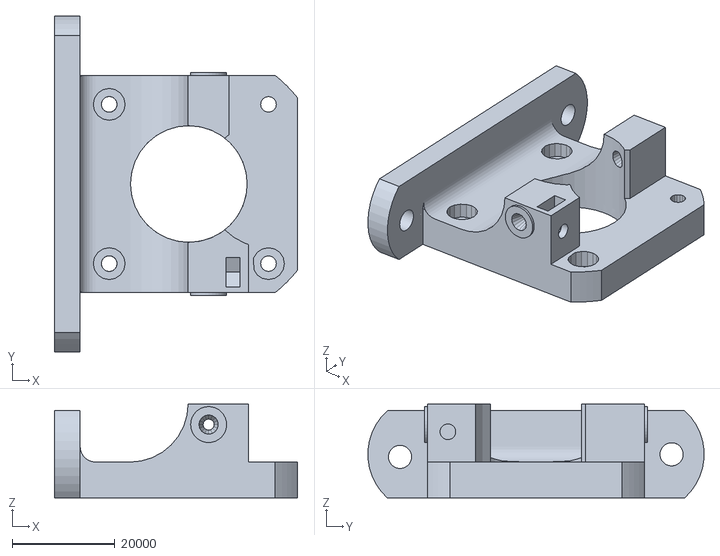
[picture p65: CAD file, 2019-02-17]
MICROMAKE 模型/全套非标件模型/送丝机.STL
47300.0 x 65387.7 x 18290.0
