dumpinfo/MICROMAKE_3D/MICROMAKE 模型/全套非标件模型/送丝机垫片.STL

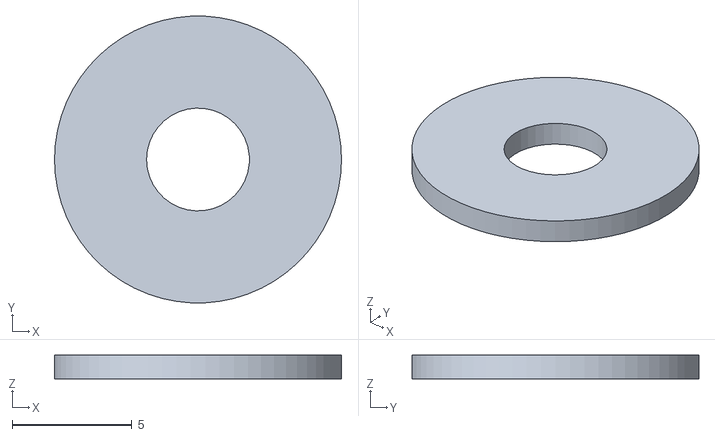
[picture p66: CAD file, 2019-02-17]
MICROMAKE 模型/全套非标件模型/送丝机垫片.STL
12.0 x 12.0 x 1.00
